voroshkov/Chorus-LED-Module/(list of files, drawings)

Other design files:
DipTrace/ChorusLedModule.dch
