voroshkov/Chorus-LED-Module/(threads)

Thread 1 (2018-02-02):

WS2812-driver.ino:29:32: fatal error

cejas99, 2018-02-02:
Hi
WS2812-driver.ino:29:32: fatal error: PinChangeInterrupt.h: No such file or directory

 #include <PinChangeInterrupt.h>

                                ^

compilation terminated.

exit status 1

voroshkov, 2018-02-02:
plz install the corresponding library

cejas99, 2018-02-02:
Hi Andrey, what is the library?
________________________________
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

voroshkov, 2018-02-06:
Obviously it's "PinChangeInterrupt" library :)
I instaled it via Arduino IDE library manager, so don't know how to find it in a different way.

Thread 2 (2020-03-03):

problem led

enricoroor, 2020-03-03:
hello ... first of all congratulations for the project even if old ... I'm trying to build it but I have a problem ...
I have assembled everything following the scheme ... the only thing I have put for now is the resistance on the LED signal cable.
I uploaded the two different sketches for the two Arduino and in the second i asked for a couple of booklets
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
I tried to connect everything and power everything with two lipo ... one for the timer and one for the LEDs ... a bec for the LEDs powers the LED and Arduino mini interior ... everything lights up connects and speaks with the application but I see that the Arduino led do not speak (led tx-rx) even if the Arduino of the timer are going and I have an answer from the app
I retraced all the connections and found no errors ... I have doubts about the Arduino libraries that I had to put

enricoroor, 2020-03-03:
i using this arduino nano
https://www.amazon.it/gp/product/B0716S43Q2/ref=ppx_yo_dt_b_asin_title_o02_s00?ie=UTF8&psc=1
