voroshkov/Chorus-LED-Module/(commit log)

2017-10-02 initial commmit
    [ChorusLedModule.dch]
2017-10-27 fix bug with handling of Serial input data, rename to use underscores
    [chorus_led_module.ino, pinAssignments.h]
